T-Py-T/CPAPtoVentilator/MainController/Docs/BOM.xlsx

Sheet: CPAP COST
CPAP UNITS
 |  |  |  |  |  |  | $2512.58 | $2725.52 | $2953.09
 | BILL OF MATERIAL |  |  |  |  |  |  |  | SPENT PER 25 UNITS
 | ITEM | QUANTITY | PART NUMBER | DEVICE | MANUFACTURER | DESCRIPTION | COST EA. | COST PER UNIT
 | 1 | 1 | 57374 | UPPER BOARD | ADVANCED CIRCUITS | UPPER PCB BOARD | $21.96 | $21.96
 | 2 | 1 | 57388 | LOWER BOARD | ADVANCED CIRCUITS | LOWER PCB BOARD | $24.87 | $24.87
 | 3 | 2 | SDP2000-L | PRESSURE SENSOR | SENSIRION | 0-3500 Pa, Differential, 5V 3.4 mm Port, analog | $91.37 | $182.74
 | 4 | 1 | LAUNCHXL-F28069M | DRIVE INTERFACE | TEXAS INSTRUMENTS | Booster pack interface | $29.49 | $29.49
 | 5 | 1 | BOOSTXL-DRV8305EVM | MOTOR DRIVE UNIT | TEXAS INSTRUMENTS | Booster pack | $93.22 | $93.22
 | 6 | 1 | TEENSY32 | LOGIC CONTROLLER | PJRC.COM LLC | USB-based microcontoller development system | $21.88 | $21.88
 | 7 | 1 | 318-ENC130175F-12PS | ROTARY ENCODER | ALPHA | Digital Rotary Encoder Module | $4.10 | $4.10
 | 8 | 1 | 450-BA600 | KNOB | EAGLE PLASTIC | Knob for Encoder | $1.29 | $1.29
 | 9 | 1 | NHD-240128WG-BTFH-VZ# | DISPLAY | NEW HAVEN DISPLAY | LCD MOD GRAPH 240X128 WH TRANSFL | $72.03 | $72.03
 | 10 | 2 | 1009 | TACTILE BUTTON | ADAFRUIT | ROUND TACTILE BUTTON SWITCH | $5.36 | $10.72
 | 11 | 1 | 469930611 | PLUG | Molex | CONN PLUG HSG 6POS 4.20MM | $0.65 | $0.65
 | 12 | 4 | 304902002 | PIN | Molex | CONN PIN 18-24AWG CRIMP TIN | $0.08 | $0.32
 | 13 | 1 | 691101710003 | TERMINAL BLOCK | Wurth Elektronik | THT 3 Positions 5.0 mm Pitch 16A | $0.83 | $0.83
 | 14 | 1 | 500/B | CASE | B & W INTERNATIONAL | Case, 9" x 7.2" x 3.7", Black, Plastic | $25.45 | $25.45
 | 15 | 1 | 2858 | VOLTAGE REGULATOR | POLOLU | 5V, 2.5A Step-Down Voltage Regulator D24V22F5 | $7.16 | $7.16
 | 16 | 5 | K104K15X7RF53H5 | CAPACITOR | VISHAY | Capacitor 0.1uF 50volts 10% X7R 5mm LS | $0.10 | $0.50
 | 17 | 1 | 9212-17 | 20 PIN CABLE | MIRAC | 20 PIN CABLE 12" | $15.74 | $15.74
 | 18 | 1 | 9212-18 | 8 PIN CABLE | MIRAC | 8 PIN CABLE 12" | $3.73 | $3.73
 | 19 | 1 | MSS5MMG | BUZZER | MALLORY SONALERT | AUDIO MAGNETIC INDICATOR 4-6V TH | $17.87 | $17.87
 | 20 | 1 | S3B-XH-SM4-TB(LF)(SN) | 3 CONN SOCKET | JST Sales America Inc. | CONN HEADER SMD R/A 3POS 2.5MM | $0.54 | $0.54
 | 21 | 1 | 3361P-1-103GLF | Potentiometer | Bourns Inc. | TRIMMER 10K OHM 0.5W GW TOP ADJ | $1.02 | $1.02
 | 22 | 2 | TPSR106K006R1000 | CAPACITOR | AVX Corporation | CAP TANT 10UF 10% 6.3V 0805 | $0.76 | $1.52
 | 23 | 1 | EEE-FK1V331P | CAPACITOR | Panasonic Electronic | CAP ALUM 330UF 20% 35V SMD | $0.80 | $0.80
 | 24 | 3 | 9212-24 | POWER CABLE | MIRAC | 3 CONDUCTOR 18 AWG | $41.96 | $125.88
 | 25 | 6 | SJ5303-7 | BUMPERS | 3M | RUBBER BUMPERS | $0.07 | $0.42
 | 26 | 1 | M20-1060400 | CONNECTOR | Harwin Inc. | CONN RCPT HSG 4POS 2.54MM | $0.63 | $0.63
 | 27 | 1 | 1800 | WIRES | POLOLU | Pre-Crimped Terminals 50-Piece 10-Color Assortment F-F 6" | $8.95 | $8.95
 | 28 | 11 | 91828A211 | NUTS | McMaster-Carr | 18-8 SS M3 NUTS | $0.06 | $0.61
 | 29 | 8 | 90991A112 | SCREW | McMaster-Carr | 18-8 SS M3X6 TORX. | $0.04 | $0.35
 | 30 | 4 | 93655A093 | STAND-OFF | McMaster-Carr | 18-8 SS 6MM STAND-OFF | $2.90 | $11.60
 | 31 | 2 | 93655A095 | STAND-OFF | McMaster-Carr | 18-8 SS 8MM STAND-OFF | $3.04 | $6.08
 | 32 | 2 | 93655A097 | STAND-OFF | McMaster-Carr | 18-8 SS 10MM STAND-OFF | $3.17 | $6.34
 | 33 | 5 | 93655A354 | STAND-OFF | McMaster-Carr | 18-8 SS 16MM STAND-OFF | $3.58 | $17.90
 | 34 | 2 | 98689A112 | WASHER | McMaster-Carr | 18-8 SS M3 WASHER. | $0.03 | $0.05
 | 35 | 3 | 90991A114 | SCREW | McMaster-Carr | 18-8 SS M3X10 TORX. | $0.04 | $0.13
 |  |  |  |  |  |  |  | $0.00
 | BILL OF MATERIAL |  |  |  |  |  |  | $0.00
 | ITEM | QUANTITY | PART NUMBER | DEVICE | MANUFACTURER | DESCRIPTION |  | $0.00
 | 1 | 1 | 1060802 | MASK | Philips Respironics | FitLife Total Face CPAP Mask | $200.00 | $200.00
 | 2 | 1 | 1132982 | EXHALATION PORT | Philips Respironics | CPAP Exhalation Port | $5.60 | $5.60
 | 3 | 1 | 342777 | FILTER | Philips Respironics | VIRAL/BACTERIAL FILTER | $10.00 | $10.00
 | 4 | 1 | HCG72 | CPAP TUBING | Home Health Medical | 6' CPAP TUBING | $10.99 | $10.99
 | 5 | 1 | 1302 | TUBING | Vyaire Medical | 7' CLEAR TUBING, SMOOTH | $0.80 | $0.80
 | 6 | 1 | DSX400S11 | CPAP UNIT | Philips Respironics | CPAP Unit | $399.00 | $399.00
 | 7 | 1 | 9212 | ENCLOSURE W/CONTROLS | AES | Assembled Enclosure | $0.00 | $0.00
 | 8 | 1 | ME240A2451N01 | POWER SUPPLY | SL Power Electronics | 240W, 24V DC, MOLEX Connector | $131.04 | $131.04
 | 9 | 1 | AC15WNA | POWER CORD | Phihong USA | 6' Power Cord Black | $2.27 | $2.27
 |  | 4 |  |  |  | silicon tapered plug | $0.11 | $0.44
 |  | 1 |  |  |  | AES Personnel est | $350.00 | $350.00
 |  | 1 |  |  |  | Bobby & Kary | $448.00 | $448.00
 |  | 1 |  |  |  | granger | $450.00 | $450.00
 |  |  |  |  |  |  |  | $0.00
 |  |  |  |  |  |  |  | $0.00

Sheet: V2 Hardware Cost
 | Ventilator Ver 2.0 Bill Of Materials
 |  |  |  |  |  |  |  | BUILD QUANTITY 1 COST
 | ITEM | QUANTITY | PART NUMBER | MANUFACTURER | VENDOR | VENDOR STOCK NO. | DESCRIPTION | $432.93
https://www.amazon.com/SKB-3I-1209-4B-Military-Standard-Waterproof/dp/B000Z3204Q | 1 | 1 |  |  |  |  | Interior Length: 12.00 in (30.48 cm) Interior Width: 9.00 in (22.86 cm) Interior Depth: 4.50 in (11.43 cm) Black, Plastic
 | 2 | 1 |  |  |  |  | UPPER PCB BOARD , CONTROL PB's AND KNOBS
 | 3 | 1 |  |  |  |  | LOWER PCB BOARD
 | 4 | 1 | SDP2000-L | SENSIRION | Arrow Electronics | SDP2000-L | 0-3500 Pa, Differential, 5V 3.4 mm Port, analog | $71.14
 | 5 | 1 | TEENSY32 | PJRC | PJRC | TEENSY32 | USB-based microcontroller development system | $19.80
 | 6 | 1 | RE130F-41-175F-12P | ALPHA | Mouser | 318-ENC130175F-12PS | Digital Rotary Encoder Module | $4.10
 | 7 | 1 | 450-BA600 | EAGLE PLASTIC | Mouser | 450-BA600 | Knob for Encoder | $1.29
https://www.digikey.com/product-detail/en/newhaven-display-intl/NHD-320240WG-BOTFH-VZ/NHD-320240WG-BOTFH-VZ-ND/1701314 | 8 | 1 | NHD-320240WG-BOTFH-VZ# | NEW HAVEN DISPLAY | Digi-Key | NHD-320240WG-BOTFH-VZ#-ND | Graphic LCD Display Module Transflective FSTN - Film Super-Twisted Nematic Parallel, 8-Bit 320 x 240 (QVGA) | $83.86
 | 9 | 2 | 1009 | ADAFRUIT | Mouser | 485-1009 | Round Tactile Button Switch Assortment (Not all are used) | $10.72
 | 10 | 4 | 304902002 | Molex | Digi-Key | WM2985TR-ND | CONN PIN 18-24AWG CRIMP TIN | $0.28
 | 11 | 1 | 691101710003 | Wurth Elektronik | Digi-Key | 732-2027-ND | THT 3 Positions 5.0 mm Pitch 16A | $0.96
 | 12 | 1 | 691101710002 | Wurth Elektronik | Digi-Key | 732-2026-ND | THT 2 Positions 5.0 mm Pitch 16A | $0.69
 | 13 | 1 | 2858 | Pololu | Pololu | 2858 | 5V, 2.5A Step-Down Voltage Regulator D24V22F5 | $8.95
 | 13 | 5 | K104K15X7RF53H5 | VISHAY | Mouser | 594-K104K15X7RF53H5 | Capacitor 0.1uF 50volts 10% X7R 5mm LS | $0.55
 | 14 | 1 | MSS5MMG | MALLORY SONALERT | Digi-Key | 458-1405-ND | AUDIO MAGNETIC INDICATOR 4-6V TH | $26.96
 | 15 | 2 | S3B-XH-SM4-TB(LF)(SN) | JST Sales America Inc. | Digi-Key | 455-2263-1-ND | CONN HEADER SMD R/A 3POS 2.5MM | $1.38
 | 16 | 1 | 3361P-1-103GLF | Bourns Inc. | Mouser | 652-3361P-1-103GLF | Trim Potentiometer 10K OHM 0.5W GW Top Adj | $1.02
 | 17 | 2 | TPSR106K006R1000 | AVX Corporation | Digi-Key | 478-9265-1-ND | Capacitor Tantalum 10UF 10% 6.3V 0805 | $1.38
 | 18 | 1 | EEE-FK1V331P | Panasonic Electronic | Digi-Key | PCE3841CT-ND | Capacitor Aluminum 330UF 20% 35V SMD | $0.80
 | 19 | 6 | SJ5303-7 | 3M | Digi-Key | SJ5303-7-ND | RUBBER BUMPERS | $0.36
 | 21 | 1 | 1800 | Pololu | Pololu | 1800 | Pre-Crimped Terminals 50-Piece 10-Color Assortment F-F 6" | $9.95
 | 22 | 11 | 91828A211 | McMaster-Carr | McMaster-Carr | 91828A211 | 18-8 SS M3 NUTS | $0.61
 | 23 | 8 | 90991A112 | McMaster-Carr | McMaster-Carr | 90991A112 | 18-8 SS M3X6 TORX. | $0.35
 | 24 | 4 | 93655A093 | McMaster-Carr | McMaster-Carr | 93655A093 | 18-8 SS 6MM STAND-OFF | $11.60
 | 25 | 2 | 93655A095 | McMaster-Carr | McMaster-Carr | 93655A095 | 18-8 SS 8MM STAND-OFF | $6.08
 | 26 | 2 | 93655A097 | McMaster-Carr | McMaster-Carr | 93655A097 | 18-8 SS 10MM STAND-OFF | $6.34
 | 27 | 5 | 93655A354 | McMaster-Carr | McMaster-Carr | 93655A354 | 18-8 SS 16MM STAND-OFF | $17.90
 | 28 | 2 | 98689A112 | McMaster-Carr | McMaster-Carr | 98689A112 | 18-8 SS M3 WASHER. | $0.05
 | 29 | 3 | 90991A114 | McMaster-Carr | McMaster-Carr | 90991A114 | 18-8 SS M3X10 TORX. | $0.13
 | 30 | 1 | RES019 | SUNSET HEALTHCARE | Stomabags | RES019 | Rear Air Circuit Pass-Through | $0.20
 | 31 | 1 | BOOSTXL-DRV8305EVM | Texas Instruments | AES |  | DRV8305 3 phase motor drive booster pack evaluation module
 | 32 | 1 | LAUNCHXL-F28069M | Texas Instruments | AES |  | InstaSPIN-MOTION enabled C2000 Piccolo LaunchPad with TMS320F28069M 32-Bit Real Time Microcontroller, 90 MHz, 256KB Flash, 96KB RAM
 | 33 | 1 | 2002-7-50 | SALTER LABS | MedEquipDepot | 2002-7-50 | 3/16" ID, Oxygen Tubing, 7', Clear | $0.22
 | 34 | 1 | SDP-816-500PA (1-101595-01) | SENSIRION | Digi-Key | 1649-1076-ND | 0-500 Pa, Differential, 5V 3.4 mm Port, analog | $30.69
https://www.digikey.com/product-detail/en/tdk-lambda-americas-inc/CUS150M24/285-2809-ND/7695389 | 35 | 1 | CUS150M-24 | TDK-Lambda Americas | Digi-Key | 285-2809-ND | 240W, 24V DC, MOLEX Connector | $63.00
 | 36 | 1 | 17249 10 B1 | Volex Power Cords | Allied Electronics | 70115986 | Cord; Power; C13; 5-15P Plug; 3 Cond SVT Cbl; 6ft.; 18 AWG; Black PVC Jkt; Plastic Ins | $3.50
https://www.newark.com/volex/17252a-0-b1/connector-power-inlet-c14-receptacle/dp/45P4893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 | 37 | 1 | 17252A 0 B1 | Volex Power Cords | Newark | 45P4893 | IEC Plug; 10 A/250 VAC; Solder or QC Tabs Terminal; Panel Mount; 17 Series | $1.20
https://www.newhavendisplay.com/nhdffc201-p-1100.html | 39 | 1 | NHD-FFC20-1 | NEW HAVEN DISPLAY | Digi-Key | NHD-FFC20-1-ND | — 20pin 1mm pitch FFC to 2.54mm Thru-hole adapter board Size: 20pin, 1mm pitch | $10.05
https://www.newhavendisplay.com/20-pos-ffc-p-1101.html | 40 | 1 | 20 POS FFC | NEW HAVEN DISPLAY | Digi-Key | 20_POS_FFC-ND | Flat Flex Cable (FFC), 200mm length, Size: 20pin, 1.0mm pitch | $5.00
https://www.digikey.com/product-detail/en/delta-electronics/BFN0724SS-01/603-2239-ND/10244643 | 41 | 1 |  |  | AES |  | Fan Blower
https://www.digikey.com/products/en?keywords=455-3107-ND | 42 | 1 | ASVHSVH16K205 | JST Sales America Inc. | Digi-Key | 455-3107-ND | Jumper Wire with Crimped connector ends | $0.83
https://www.digikey.com/products/en?keywords=455-1187-ND | 43 | 1 | VHR-6N | JST Sales America Inc. | Digi-Key | 455-1187-ND | Connecrtor Housing 6 pos | $0.20
https://www.digikey.com/products/en?keywords=455-2931-ND | 44 | 1 | VAR-2 | JST Sales America Inc. | Digi-Key | 455-2931-ND | 2Pos VA Connector | $0.18
https://www.1800cpap.com/cpap-tubing-18inch | 45 | 1 | TUB0018 | Sunset Healthcare Solutions | Stomabags | TUB0018 | CPAP Tubing with 22mm Cuffs, 18 inches | $2.62
https://www.grainger.com/product/4FRJ2?cm_mmc=PPC:+Google+PLA&s_kwcid=AL!2966!3!264922886802!!!g!439460816581! | 46 | 1 | 4FRJ2 | Power First | Zoro | G2732791 | Blue Female Disconnect, Vinyl Insulation Type, 16 to 14 AWG Wire Range | $0.22
https://www.digikey.com/products/en?keywords=H762-ND | 47 | 1 | MHNZ 003 | B&F Fastener Supply | Digi-Key | H762-ND | HEX NUT 0.217" M3 | $0.04
https://www.digikey.com/products/en?keywords=H744-ND | 48 | 1 | MHNZ 004 | B&F Fastener Supply | Digi-Key | H763-ND | M3 Pan Head Machine Screw Phillips Drive | $0.05
https://www.digikey.com/products/en?keywords=952-3082-ND | 49 | 8 | R30-1001302 | Harwin Inc. | Digi-Key | 952-3082-ND | Hex Standoff Threaded M3x0.5 Brass 0.512" (13.00mm) | $3.84
https://www.digikey.com/products/en?keywords=952-1504-ND | 50 | 4 | R30-3001302 | Harwin Inc. | Digi-Key | 952-1504-ND | Hex Standoff Threaded M3x0.5 Brass 0.512" (13.00mm) | $2.96
https://www.digikey.com/product-detail/en/vector-electronics/12X12WE/V2041-ND/1886434 | 51 | 1 | 12X12WE | Vector Electronics | Digi-Key | V2041-ND | Proto Board FR4 Epoxy Glass 12.00" x 12.00" (304.8mm x 304.8mm) | $15.71
https://www.digikey.com/product-detail/en/advanced-cable-ties-inc/AL-MP-1000-0-C/2162-AL-MP-1000-0-C-ND/10380716 | 52 | 1 | AL-MP-1000-0-C | Advanced Cable Ties, Inc. | Digi-Key | 2162-AL-MP-1000-0-C-ND | Quad Opening Cable Tie Holder Black Adhesive, Screw, #6 | $0.18
https://www.digikey.com/products/en?keywords=455-2964-1-nd | 53 | 10 | SVA-41T-P1.1 | JST Sales America Inc. | Digi-Key | 455-2964-1-ND | Socket Contact Tin 18-20 AWG Crimp | $0.40
https://www.digikey.com/product-detail/en/alpha-wire/F221B1-8-BK100/A018B-4-ND/281671 | 54 | 1 | F221B1/8 BK100 | Alpha Wire | Digi-Key | A018B-4-ND | Heat Shrink Tubing, Flexible 0.125" (3.18mm) 2 to 1 Black 4.00' (1.22m), 1 ft. | $1.90
 | 55 | 2 | M20-1060400 | HARWIN Inc. | Digi-Key | 952-2229-ND | HSG 4POS 54mm Connector RCPT | $0.42
 | 56 | 1 | VHR-6N | JST Sales America Inc. | Digi-Key | 455-1187-ND | VH 6Pos 3.96mm Connector White | $0.20
 | 57 | 2 | NGW-600pcs | NGW | Amazon | NGW-600pcs | 2.54mm 1x1p Connector Housing Female | $0.40
 | 58 | 2 | NGW-800pcs | NGW | Amazon | NGW-800pcs | 2.54mm 1x4p Connector Housing Female | $0.38
 | 59 | 2 | VUPN7202 | Vetco | Vetco | VUPN7202 | 2.54mm 1x3p Connector Housing Female | $1.28
