T-Py-T/CPAPtoVentilator/MainController/Docs/CPAP_Vent_BuildGuide.pdf

1

# Ventilator Version 2

# Build Notes

# Connection Reference

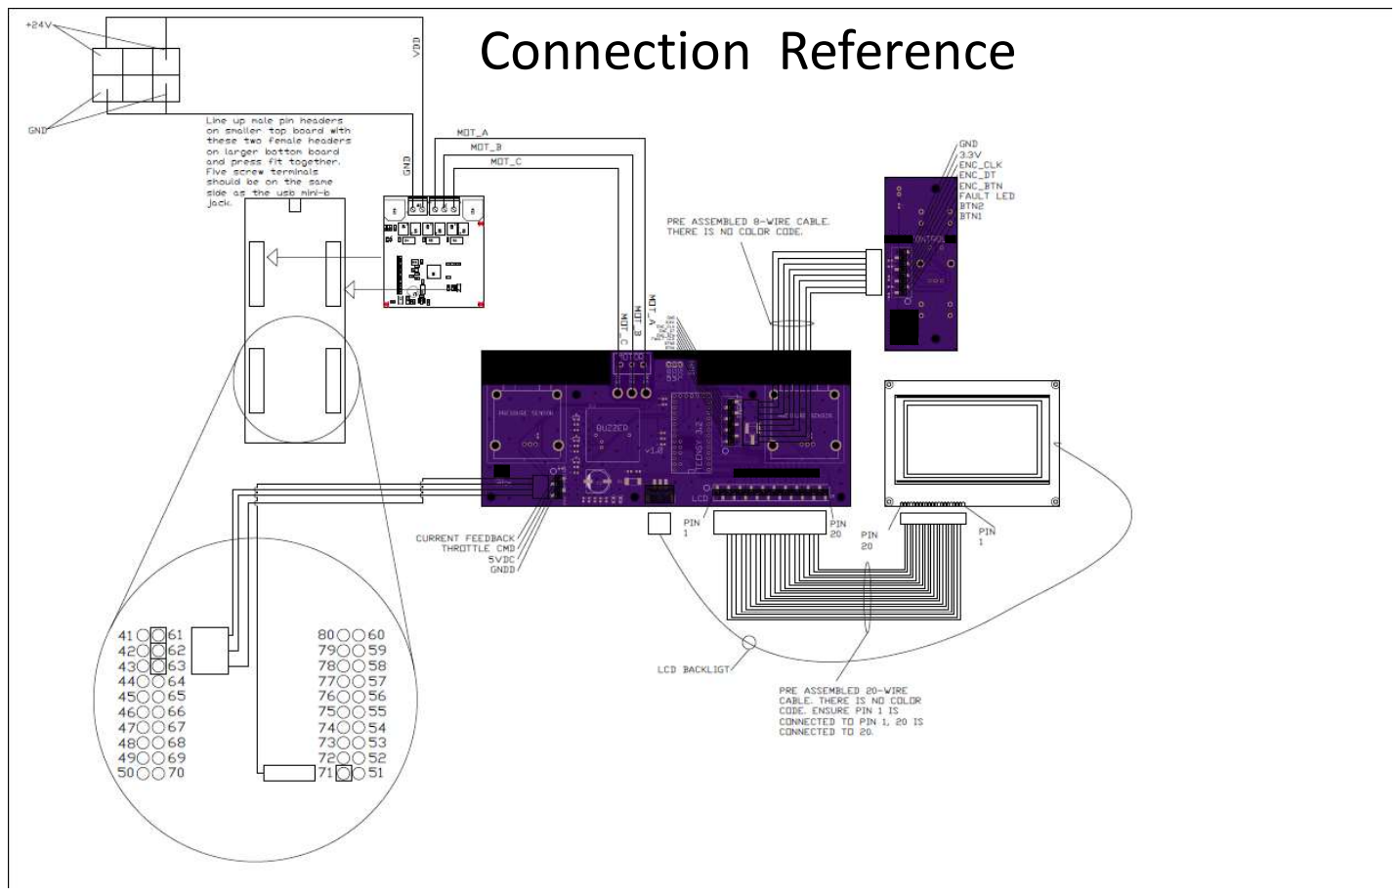
[picture p6: page 2]

2

# Soldering Reference Front

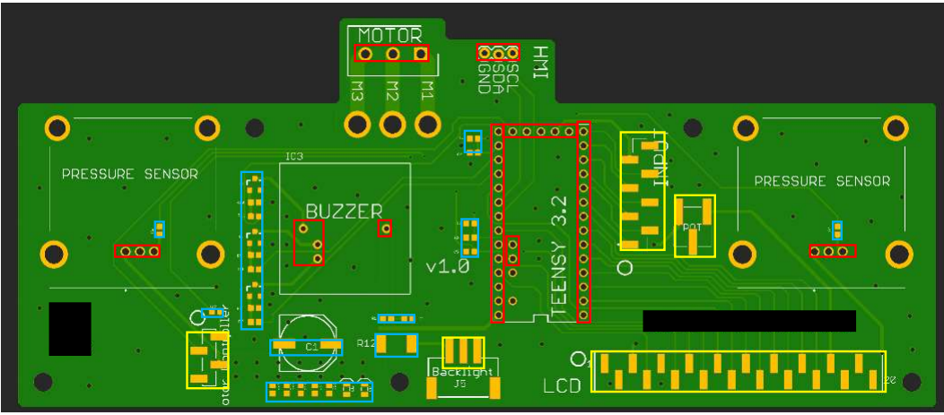
[picture p7: figure]

= Resistors / Capacitors (Surface) | = Surface Mount (Headers)
| 3

= Through Pin

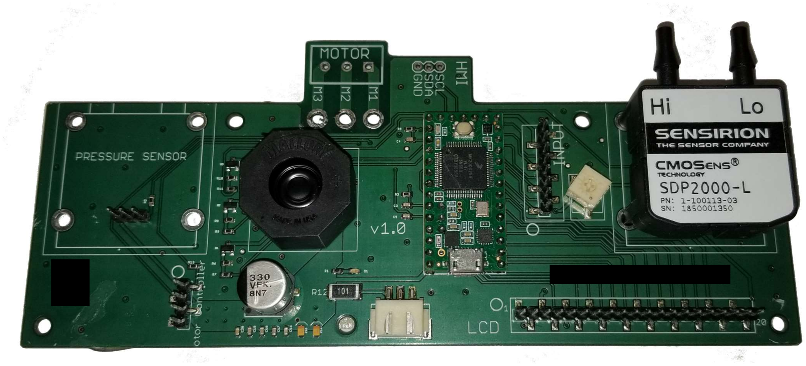
[picture p8: figure]

4

# Assembled Circuit Board

# Soldering Reference Sub-Component

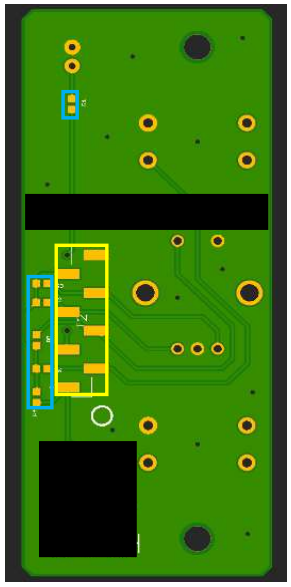
[picture p9: figure]
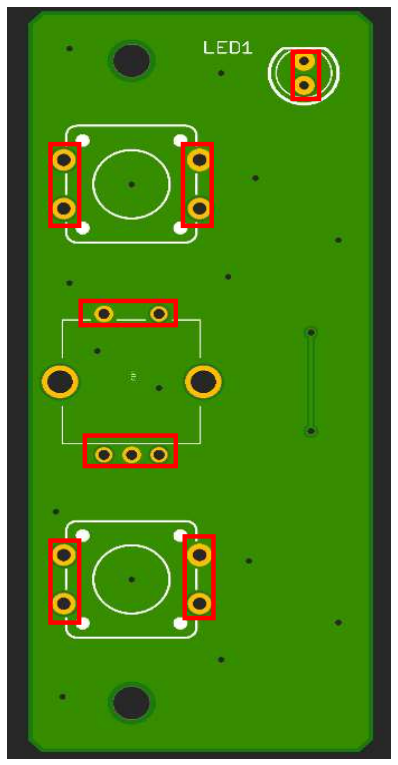
[picture p10: figure]

= Through Pin | = Resistors / Capacitors (Surface) | = Surface Mount (Headers)
| | 5
Back (PCB Facing) | Front (Panel Facing)

# Assembled Sub-Component

6

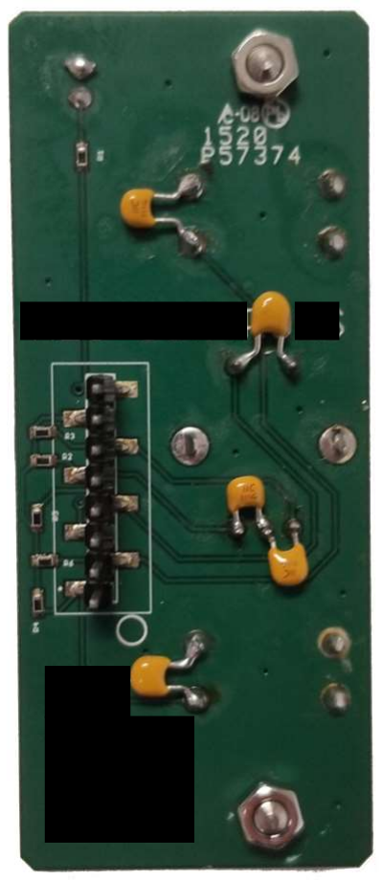
[picture p11: figure]
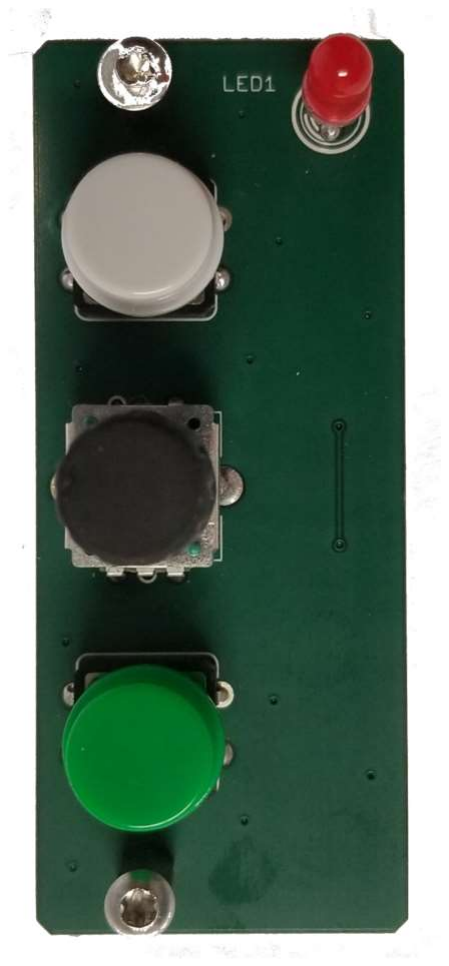
[picture p12: figure]

Top View | Bottom View

# Soldering Reference (Teensy)

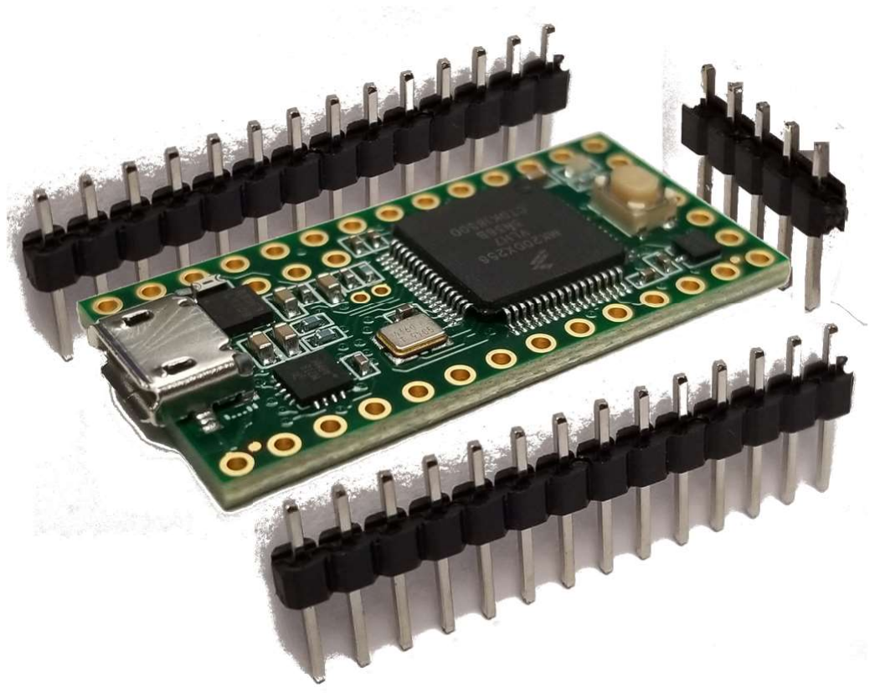
[picture p13: figure]
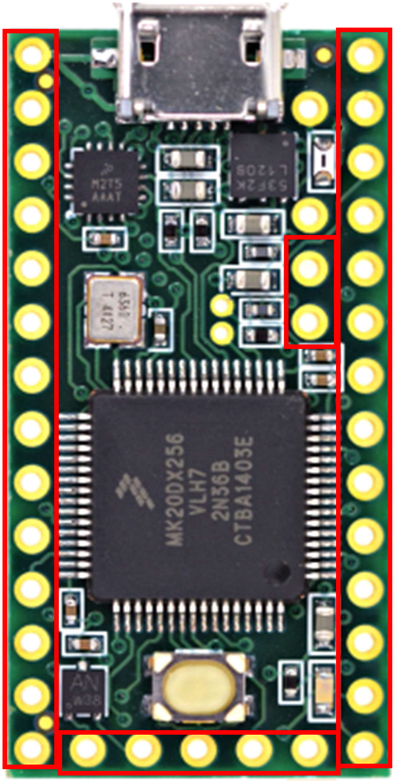
[picture p14: figure]

= Through Pin | = Resistors / Capacitors (Surface) | = Surface Mount (Headers)
| | 7

TEENSY 3.2

# Soldering Reference (LCD)

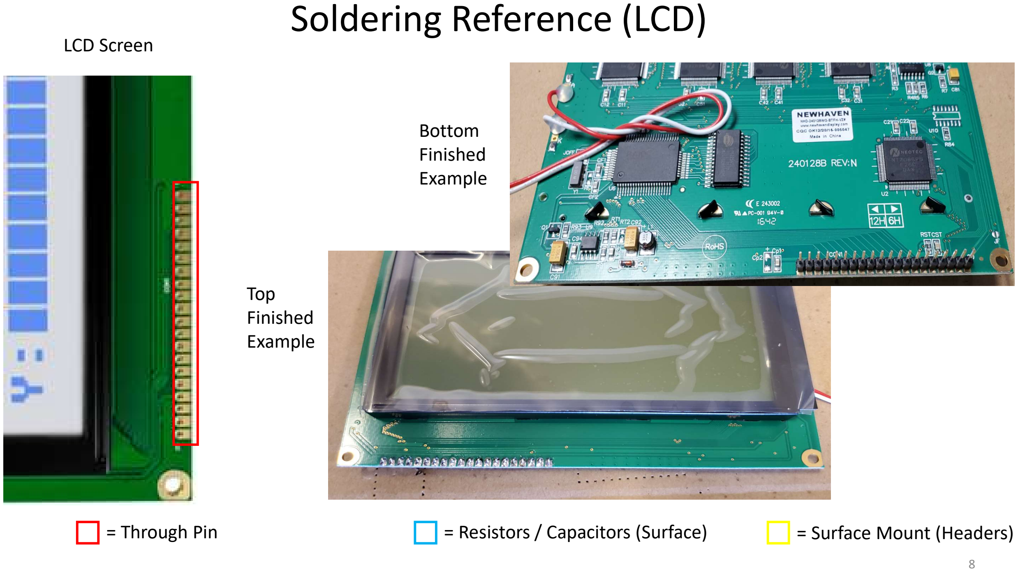
[picture p15: page 8]

= Through Pin | = Resistors / Capacitors (Surface) | = Surface Mount (Headers)
| | 8

LCD Screen

Top
Finished
Example

Bottom
Finished
Example

# Main PCB to Input PCB connections

## GND

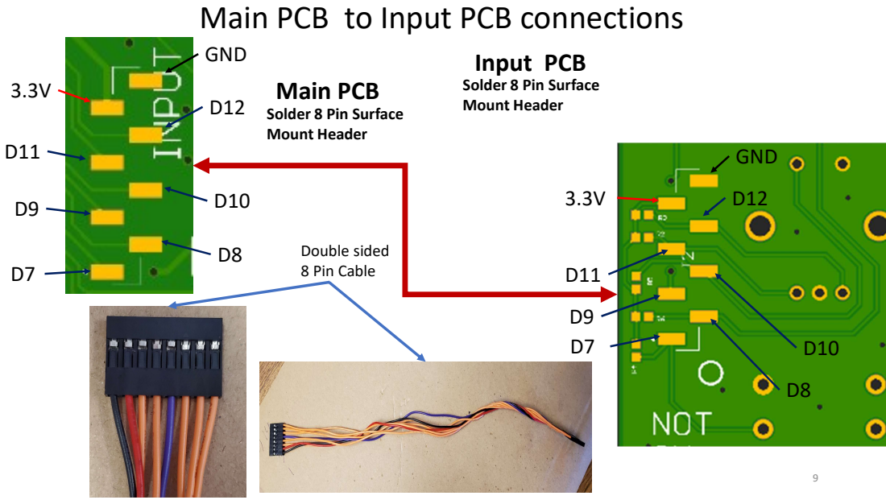
[picture p16: page 9]
Solder 8 Pin Surface Main PCB; Mount Header; Input PCB; GND; Double sided 8 Pin Cable

Solder 8 Pin Surface
Mount Header

# Main PCB to LCD connections

## Main PCB

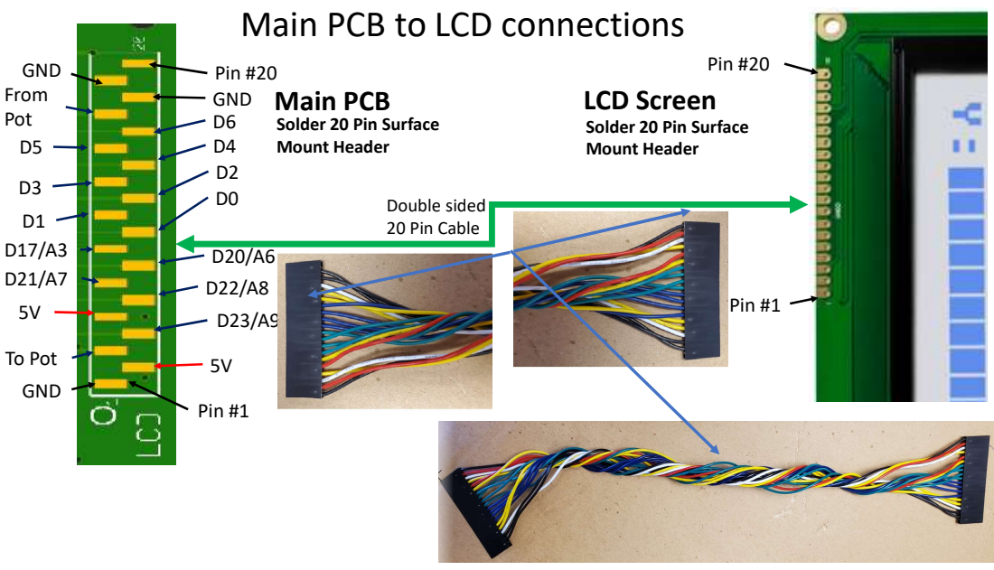
[picture p17: page 10]
Pin #1; Pin #20; GND; GND From Pot; To Pot; Double sided 20 Pin Cable; Solder 20 Pin Surface Mount Header

LCD Screen
Solder 20 Pin Surface
Mount Header

# Main PCB to TI Board connections

## Main PCB

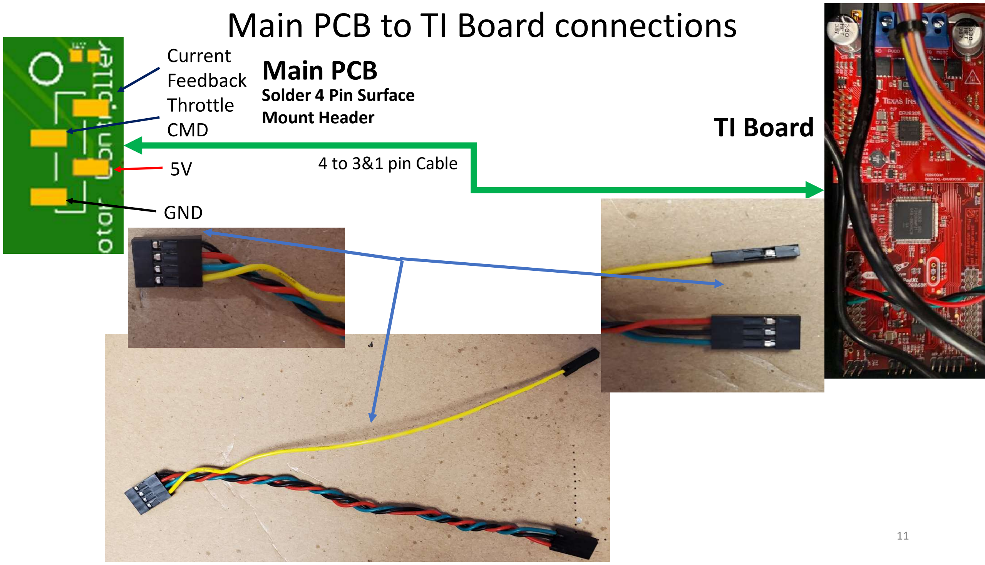
[picture p18: page 11]

11

### 4 to 3&1 pin Cable

Solder 4 Pin Surface
Mount Header

## TI Board

5V
GND

Current
Feedback
Throttle
CMD

# As-Built Images

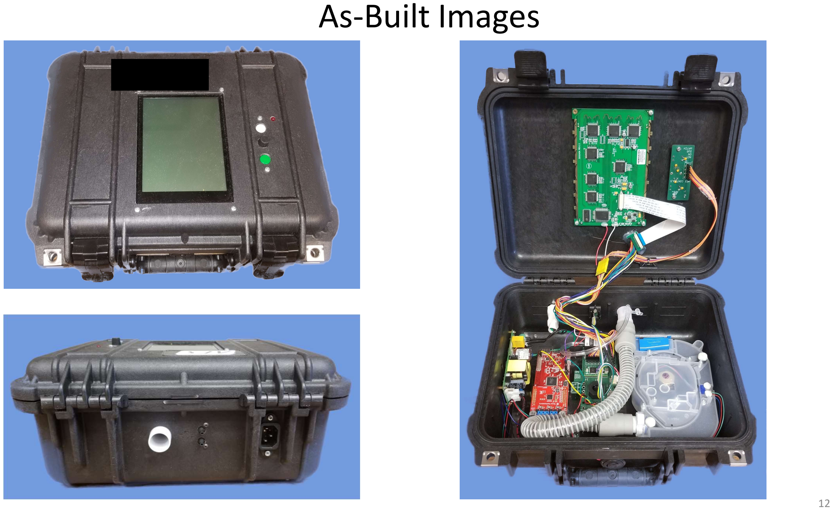
[picture p19: page 12]

12

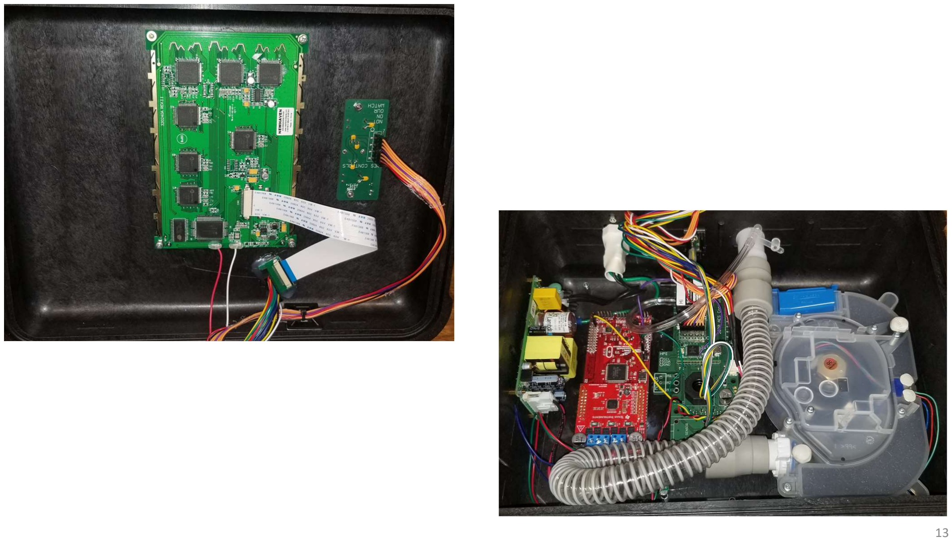
[picture p20: page 13]

13
